DitroniX/RMIS-Remote-Monitoring-IoT-System/README.md

## RMIS (Remote Monitoring IoT System - 4 Channel) SDK

UPDATE: 20th April 2026.  This evaluation board is no longer supported.

RMIS (Remote Monitoring IoT System)  Max 60V @ 30A 4 Channel)

Ideal for remote monitoring DC Voltage and Current of:

- Green Energy Systems
- Renewable Energy Systems
- Batteries (12/24/48V)
- Solar Panels
- Wind Generators (12/24/48V)
- Hydro Power Generators
- Rain Gutter Power Generators
- Thermoelectric Power Generator
- Water Tower Power Generators
- Turbines

Display-Type-B

- The board will monitor 4 x channels
	- Each +/- 30A current and voltage up to 60V DC. (30V Version also available)
		- 8 x channels in total.
		- Allow monitoring of charge and discharging of current sources.
		- Voltage monitoring, on each channel, can be isolated from current, if needed.
		- Ideal maximum continuous current 15A, per channel.
- Each of these channels are isolated.
- Common ground for voltage monitoring.
- The current measured is also positive and negative, so RMIS can monitor both charging and discharging DC currents in each channel.  This makes it ideal for battery monitoring, solar and wind charging etc.
- In addition, the board has a digital temperature sensor included.
-	 Provides feedback on the PCB and ambient temperature.
- On board 5V and 3V3 regulators.
	- 	Maximum of 15V DC input to the PCB  power.
	- 	DC Input Voltage monitored by separate input to ESP8266 ADC.
- Compact Board
- Easy to install and setup

Tags: Charging, Current Monitoring, Discharging, ESP-12S, ESP8266, GB3FW, GB3JT, Home Automation, IoT, Power Consumption, Remote Monitoring, SDK, Solar, STEM, ThingSpeak, Voltage Monitoring, Wind

## **Further Information**

Additional information, and other technical details on this project, maybe found in the related repository pages.

**Repository Folders**

 - **Code** *(Code examples for Arduino  IDE and PlatformIO)*
 -  **Datasheets and Information** *(Component Datasheets, Schematics, Board Layouts, Photos, Technical Documentation)*
 - **Certification** *(Related Repository Project or Part, Certification Information)*

**Repository Tabs**

 - **Wiki** *(Related Repository Wiki pages and Technical User Information)*
 - **Discussions** *(Related Repository User Discussion Forum)*
 - **Issues** *(Related Repository Technical Issues and Fixes)*

***

We value our Customers, Users of our designs and STEM Communities, all over the World . Should you have any other questions, or feedback to share to others, please feel free to:

* Visit the related [Project](https://github.com/DitroniX?tab=repositories) *plus the related* **Discussions** and **Wiki** Pages.  See tab in each separate repository.
* **Project Community Information** can be found at https://www.hackster.io/DitroniX
* [DitroniX.net Website - Contact Us](https://ditronix.net/contact/)
* **Twitter**: [https://twitter.com/DitroniX](https://twitter.com/DitroniX)
* [Supporting the STEM Projects - BuyMeACoffee](https://www.buymeacoffee.com/DitroniX)
*  **LinkedIN**: [https://www.linkedin.com/in/g8puo/](https://www.linkedin.com/in/g8puo/)

***Dave Williams, Maidstone, UK.***

Electronics Engineer | Software Developer | R&D Support | RF Engineering | Product Certification and Testing | STEM Ambassador

## STEM

**Supporting [STEM Learning](https://www.stem.org.uk/)**

Life is one long exciting learning curve, help others by setting the seed to knowledge.
