DitroniX/RMIS-Remote-Monitoring-IoT-System/Code/README.md

**RMIS ESP6288 DC Remote Monitor IoT System**

------------

This folder contains RMIS Example Source Code.

  Remember!
  - Set the BOARD to ESP8266 DEV Module (Any Wemos D1 or similar).
  - You may set the BAUD rate to 921600 to speed up flashing.
  - The SDK does NOT need external power to flash.  It will take Power from the USB 5V.
  
  This test code is OPEN SOURCE and formatted for easier viewing.  Although is is not intended for real world use, it may be freely used, or modified as needed.
  It is distributed on an "AS IS" BASIS, WITHOUT WARRANTIES OR CONDITIONS OF ANY KIND, either express or implied.

Further information can be found:

- **Website** https://ditronix.net/
- **WIKI**  https://ditronix.net/wiki/
- **GitHub**  https://github.com/DitroniX/
- **Shop**  https://ditronix.net/shop/

Dave Williams | G8PUO | DitroniX 1981-2024 | ditronix.net
