DitroniX/RMIS-Remote-Monitoring-IoT-System/Datasheets and Information/RMIS 12S SDK 2204-106 Connections.jpg

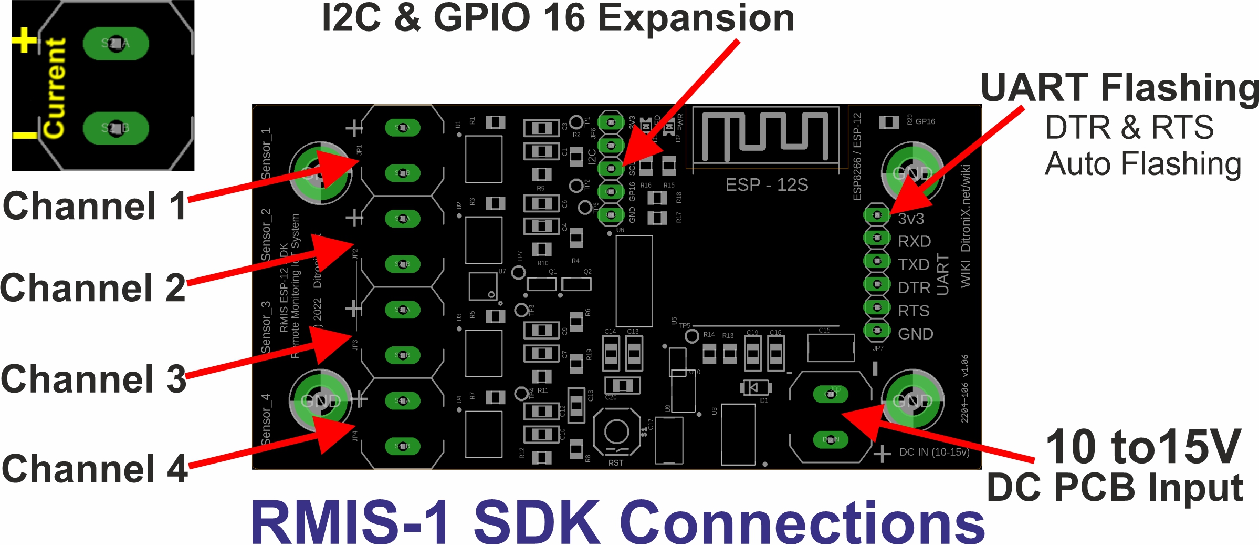
Datasheets and Information/RMIS 12S SDK 2204-106 Connections.jpg
