DitroniX/RMIS-Remote-Monitoring-IoT-System/Datasheets and Information/RMIS 12S SDK 2204-106 PCB 3D.png

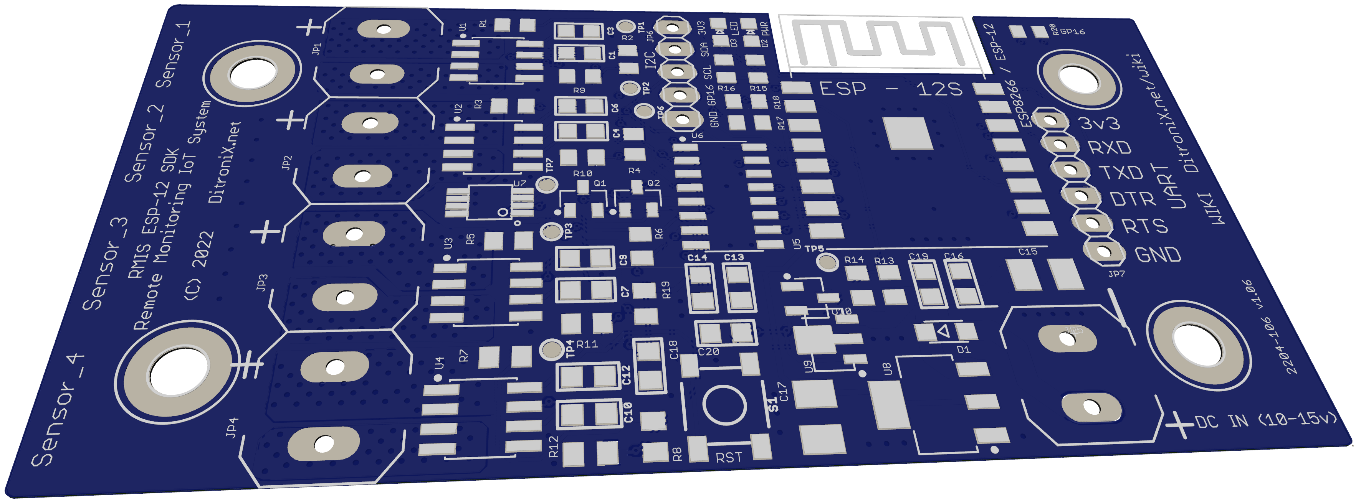
Datasheets and Information/RMIS 12S SDK 2204-106 PCB 3D.png
