DitroniX/RMIS-Remote-Monitoring-IoT-System/Datasheets and Information/RMIS-1 Channel Calculations Guide - Voltage.xlsx

Input Voltage V (At PCB + terminal) | Measured Raw ADC Value (May vary pending Tolerances) | X Example Factor | Calculated Voltage Example (RAW * X) / 1024 )
0.0 | 0 | 71.500 | 0.00
5.0 | 73 | 71.500 | 5.10
10.0 | 144 | 71.500 | 10.05
12.0 | 171 | 71.500 | 11.94
13.8 | 198 | 71.500 | 13.83
15.0 | 216 | 71.500 | 15.08
20.0 | 287 | 71.500 | 20.04
25.0 | 357 | 71.500 | 24.93
30.0 | 429 | 71.500 | 29.95
35.0 | 490 | 71.500 | 34.21
40.0 | 542 | 71.500 | 37.84
