DitroniX/RMIS-Remote-Monitoring-IoT-System/Datasheets and Information/RMIS-1 Channel Calculations Guide - Current.xlsx

Channel | Measured Current A (High Side Loading @ 12V) | Measured Raw ADC Value (May vary pending Tolerances) | X Example Factor | Calculated Current Example (Raw - 512) / X)
1 | 0.0 | 509 | 11.000 | -0.27
1 | 1.0 | 523 | 11.000 | 1.00
1 | 2.0 | 534 | 11.000 | 2.00
1 | 3.0 | 550 | 11.000 | 3.45
1 | 4.0 | 556 | 11.000 | 4.00
1 | 5.0 | 566 | 11.000 | 4.91
1 | 10.0 | 619 | 11.000 | 9.73
1 | 15.0 | 678 | 11.000 | 15.09
1 | 20.0 | 733 | 11.000 | 20.09
1 | 25.0 | 790 | 11.000 | 25.27
1 | 30.0 | 854 | 11.000 | 31.09
------ | ------ | ------ | ------ | ------
2 | 0.0 | 510 | 13.900 | -0.14
2 | 1.0 | 526 | 13.900 | 1.01
2 | 2.0 | 536 | 13.900 | 1.73
2 | 3.0 | 550 | 13.900 | 2.73
2 | 4.0 | 566 | 13.900 | 3.88
2 | 5.0 | 580 | 13.900 | 4.89
2 | 10.0 | 649 | 13.900 | 9.86
2 | 15.0 | 718 | 13.900 | 14.82
2 | 20.0 | 790 | 13.900 | 20.00
2 | 25.0 | 858 | 13.900 | 24.89
2 | 30.0 | 930 | 13.900 | 30.07
------ | ------ | ------ | ------ | ------
3 | 0.0 | 509 | 13.900 | -0.22
3 | 1.0 | 521 | 13.900 | 0.65
3 | 2.0 | 536 | 13.900 | 1.73
3 | 3.0 | 550 | 13.900 | 2.73
3 | 4.0 | 565 | 13.900 | 3.81
3 | 5.0 | 579 | 13.900 | 4.82
3 | 10.0 | 648 | 13.900 | 9.78
3 | 15.0 | 718 | 13.900 | 14.82
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
