DitroniX/RMIS-Remote-Monitoring-IoT-System/Datasheets and Information/RMIS-1 Channel Calculations Guide.xlsx

Channel | Input Voltage V (At PCB + terminal) | Measured Raw ADC Value (May vary pending Tolerances) | X Example Factor | Calculated (RAW * X) / 1024 ) | Measured Current A (High Side Loading @ 12V) | Measured Raw ADC Value (May vary pending Tolerances) | X Example Factor | Calculated (Raw - 512) / X) | Displayed V Example | Displayed A Example
1 | 0.0 | 0 | 48.500 | 0.00 | 0.0 | 509 | 11.000 | -0.27 | 0.000 | -0.230
1 | 5.0 | 107 | 48.500 | 5.07 | 1.0 | 523 | 11.000 | 1.00 | 5.010 | 0.750
1 | 10.0 | 210 | 48.500 | 9.95 | 2.0 | 534 | 11.000 | 2.00 | 9.840 | 1.890
1 | 12.0 | 252 | 48.500 | 11.94 | 3.0 | 550 | 11.000 | 3.45 | 11.810 | 2.870
1 | 13.8 | 289 | 48.500 | 13.69 | 4.0 | 556 | 11.000 | 4.00 | 13.540 | 3.400
1 | 15.0 | 315 | 48.500 | 14.92 | 5.0 | 566 | 11.000 | 4.91 | 14.760 | 4.230
1 | 20.0 | 391 | 53.000 | 20.24 | 10.0 | 619 | 11.000 | 9.73 | 18.320 | 8.150
1 | 25.0 | 440 | 58.500 | 25.14 | 15.0 | 678 | 11.000 | 15.09 | 20.620 | 12.300
1 | 30.0 | 487 | 64.000 | 30.44 | 20.0 | 733 | 11.000 | 20.09 | 22.820 | 16.830
1 | 35.0 | 535 | 67.000 | 35.00 | 25.0 | 790 | 11.000 | 25.27 | 25.070 | 21.320
1 | 40.0 | 583 | 70.500 | 40.14 | 30.0 | 854 | 11.000 | 31.09 | 27.320 | 25.740
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
